ComNets-Bremen/WUSN/PCB-Layouts/MoleNet_v5.2.2/MoleNet_V5.2.2.kicad_pcb

## KiCad design PCB-Layouts/MoleNet_v5.2.2/MoleNet_V5.2.2.kicad_pcb (2024-08-29, an earlier design)

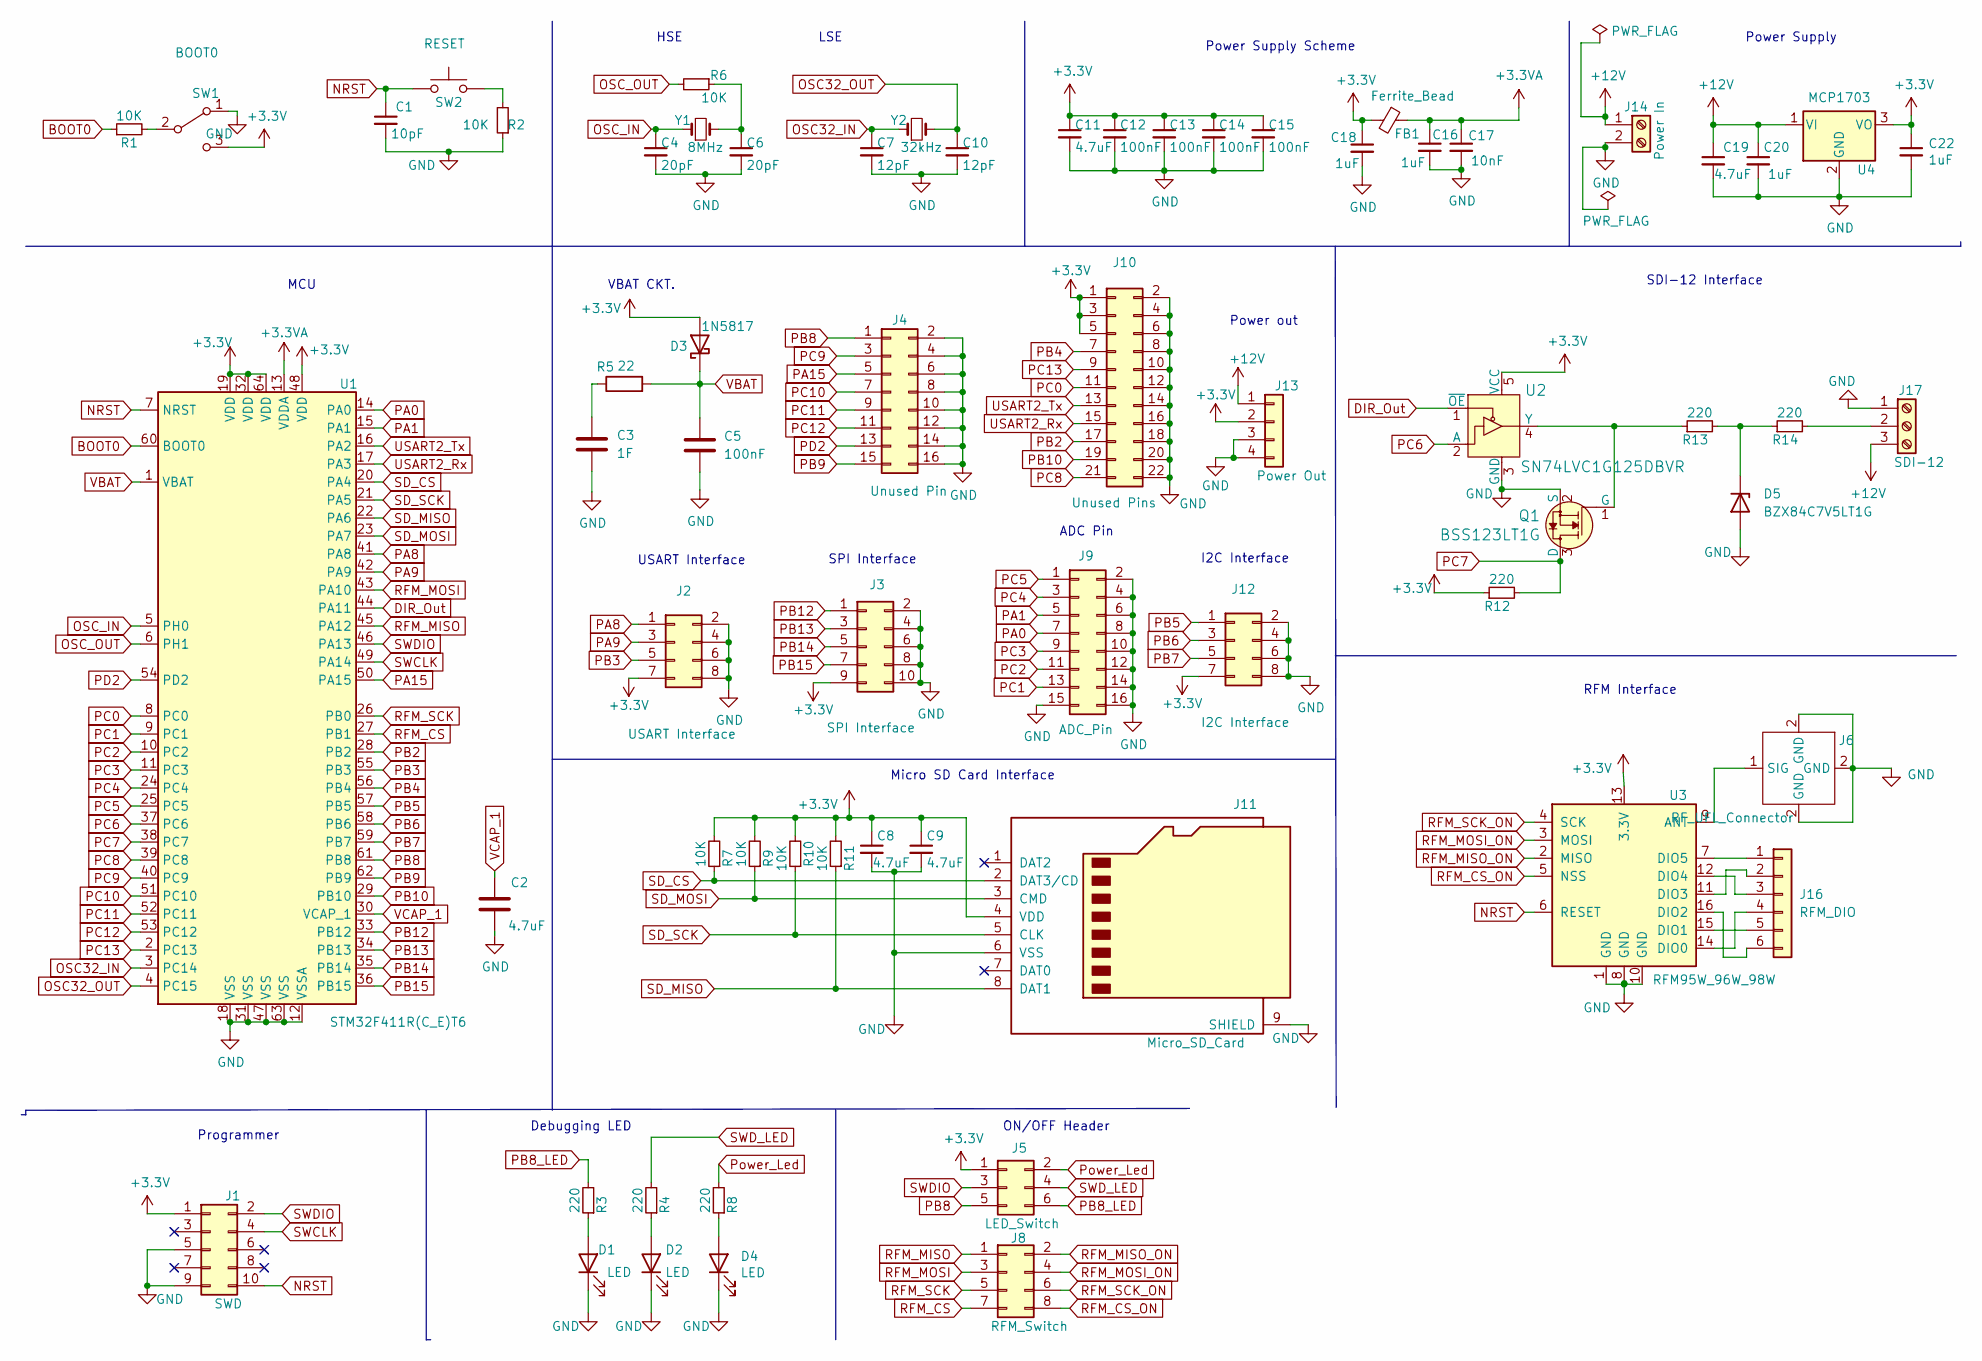
[picture p4: schematic MoleNet_V5.2.2.kicad_sch, MoleNet V5.2]

Parts:
C1: 10pF; C_0805_2012Metric
C2, C8, C9: 4.7uF; C_0402_1005Metric_Pad0.74x0.62mm_HandSolder
C3: 1F; C_Axial_L5.1mm_D3.1mm_P12.50mm_Horizontal
C4, C6: 20pF; C_0402_1005Metric_Pad0.74x0.62mm_HandSolder
C5, C12, C13, C14, C15: 100nF; C_0805_2012Metric_Pad1.18x1.45mm_HandSolder
C7, C10: 12pF; C_0402_1005Metric_Pad0.74x0.62mm_HandSolder
C11, C19: 4.7uF; C_0805_2012Metric_Pad1.18x1.45mm_HandSolder
C16, C18, C20, C22: 1uF; C_0805_2012Metric_Pad1.18x1.45mm_HandSolder
C17: 10nF; C_0805_2012Metric_Pad1.18x1.45mm_HandSolder
D1, D2, D4: LED; LED_0805_2012Metric_Pad1.15x1.40mm_HandSolder
D3: 1N5817; D_DO-41_SOD81_P10.16mm_Horizontal
D5: BZX84C7V5LT1G; SOT-23
FB1: Ferrite_Bead; L_0805_2012Metric_Pad1.05x1.20mm_HandSolder
J1: SWD; IDC-Header_2x05_P2.54mm_Vertical
J2: USART Interface; PinHeader_2x04_P2.54mm_Vertical
J3: SPI Interface; PinHeader_2x05_P2.54mm_Vertical
J4: Unused Pin; PinHeader_2x08_P2.54mm_Vertical
J5: LED_Switch; PinHeader_2x03_P2.54mm_Vertical
J6: RF_UFL_Connector; U.FL_Molex_MCRF_73412-0110_Vertical
J8: RFM_Switch; PinHeader_2x04_P2.54mm_Vertical
J9: ADC_Pin; PinHeader_2x08_P2.54mm_Vertical
J10: Unused Pins; PinHeader_2x11_P2.54mm_Vertical
J11: Micro_SD_Card; microSD_HC_Molex_104031-0811
J12: I2C Interface; PinHeader_2x04_P2.54mm_Vertical
J13: Power Out; PinHeader_1x04_P2.54mm_Vertical
J14: Power In; TerminalBlock_Phoenix_PT-1,5-2-3.5-H_1x02_P3.50mm_Horizontal
J16: RFM_DIO; PinHeader_1x06_P2.54mm_Vertical
J17: SDI-12; TerminalBlock_Phoenix_PT-1,5-3-3.5-H_1x03_P3.50mm_Horizontal
Q1: BSS123LT1G; SOT-23_Handsoldering; MPN BSS123; Digi-Key_PN BSS123NCT-ND
R1, R2: 10K; R_0805_2012Metric_Pad1.20x1.40mm_HandSolder
R3, R4, R8, R12, R13, R14: 220; R_0805_2012Metric_Pad1.20x1.40mm_HandSolder
R5: 22; R_0805_2012Metric_Pad1.20x1.40mm_HandSolder
R6, R7, R9, R10, R11: 10K; R_0402_1005Metric_Pad0.72x0.64mm_HandSolder
SW1: BOOT0; Switch_SPDT_THT
SW2: RESET; SW_PUSH_6mm_H4.3mm
U1: STM32F411R(C_E)T6; LQFP-64_10x10mm_P0.5mm
U2: SN74LVC1G125DBVR; SOT-23-5; MPN SN74LVC1G125DBVR; Digi-Key_PN 296-11603-1-ND
U3: RFM95W_96W_98W; HOPERF_RFM9XW_SMD
U4: MCP1703; SOT-223-3_TabPin2
Y1: 8MHz; Crystal_SMD_5032-2Pin_5.0x3.2mm
Y2: 32kHz; Crystal_SMD_3215-2Pin_3.2x1.5mm

Connections:
+3.3VA: C16.1, C17.1, FB1.1, U1.13 (VDDA)
+3V3: C8.1, C9.1, C11.1, C12.1, C13.1, C14.1, C15.1, C18.1, C22.1, D3.2 (A), FB1.2, J1.1, J2.7 (Pin_4), J3.9 (Pin_5), J5.1, J10.1, J10.3, J10.5, J11.4 (VDD), J12.7 (Pin_4), J13.2, R7.2, R9.2, R10.2, R11.2, R12.1, SW1.3 (C), U1.19 (VDD), U1.32 (VDD), U1.48 (VDD), U1.64 (VDD), U2.5 (VCC), U3.13 (3.3V), U4.3 (VO)
+12V: C19.1, C20.1, J13.1, J14.1, J17.3, U4.1 (VI)
BOOT0: R1.1, U1.60 (BOOT0)
DIR_Out: U1.44 (PA11), U2.1 (~OE)
GND: C1.2, C2.2, C3.2, C4.2, C5.2, C6.2, C7.2, C8.2, C9.2, C10.2, C11.2, C12.2, C13.2, C14.2, C15.2, C16.2, C17.2, C18.2, C19.2, C20.2, C22.2, D1.1 (K), D2.1 (K), D4.1 (K), D5.1 (A), J1.5, J1.9, J2.2 (Pin_5), J2.4 (Pin_6), J2.6 (Pin_7), J2.8, J3.2 (Pin_10), J3.4 (Pin_9), J3.6 (Pin_8), J3.8 (Pin_7), J3.10 (Pin_6), J4.2, J4.4, J4.6, J4.8, J4.10, J4.12, J4.14, J4.16, J6.2 (GND), J9.2, J9.4, J9.6, J9.8, J9.10, J9.12, J9.14, J9.15, J9.16, J10.2, J10.4, J10.6, J10.8, J10.10, J10.12, J10.14, J10.16, J10.18, J10.20, J10.22, J11.6 (VSS), J11.9 (SHIELD), J12.2 (Pin_5), J12.4 (Pin_6), J12.6 (Pin_7), J12.8, J13.3, J13.4, J14.2, J17.1, Q1.2 (S), R2.1, SW1.1 (A), U1.12 (VSSA), U1.18 (VSS), U1.31 (VSS), U1.47 (VSS), U1.63 (VSS), U2.3 (GND), U3.1 (GND), U3.8 (GND), U3.10 (GND), U4.2 (GND)
NRST: C1.1, J1.10, SW2.1, U1.7 (NRST), U3.6 (RESET)
unnamed: C3.1, R5.1
unnamed: C6.1, R6.1, Y1.2
unnamed: D1.2 (A), R3.1
unnamed: D2.2 (A), R4.1
unnamed: D4.2 (A), R8.1
unnamed: D5.3 (K), R13.2, R14.1
unnamed: J6.1 (SIG), U3.9 (ANT)
unnamed: J16.1, U3.7 (DIO5)
unnamed: J16.2, U3.11 (DIO3)
unnamed: J16.3, U3.12 (DIO4)
unnamed: J16.4, U3.14 (DIO0)
unnamed: J16.5, U3.15 (DIO1)
unnamed: J16.6, U3.16 (DIO2)
unnamed: J17.2, R14.2
unnamed: Q1.1 (G), R13.1, U2.4 (Y)
unnamed: R1.2, SW1.2 (B)
unnamed: R2.2, SW2.2
OSC32_IN: C7.1, U1.3 (PC14), Y2.1
OSC32_OUT: C10.1, U1.4 (PC15), Y2.2
OSC_IN: C4.1, U1.5 (PH0), Y1.1
OSC_OUT: R6.2, U1.6 (PH1)
PA0: J9.7, U1.14 (PA0)
PA1: J9.5, U1.15 (PA1)
PA8: J2.1, U1.41 (PA8)
PA9: J2.3 (Pin_2), U1.42 (PA9)
PA15: J4.5, U1.50 (PA15)
PB2: J10.17, U1.28 (PB2)
PB3: J2.5 (Pin_3), U1.55 (PB3)
PB4: J10.7, U1.56 (PB4)
PB5: J12.1, U1.57 (PB5)
PB6: J12.3 (Pin_2), U1.58 (PB6)
PB7: J12.5 (Pin_3), U1.59 (PB7)
PB8: J4.1, J5.5 (Pin_3), U1.61 (PB8)
PB8_LED: J5.6, R3.2
PB9: J4.15, U1.62 (PB9)
PB10: J10.19, U1.29 (PB10)
PB12: J3.1, U1.33 (PB12)
PB13: J3.3 (Pin_2), U1.34 (PB13)
PB14: J3.5 (Pin_3), U1.35 (PB14)
PB15: J3.7 (Pin_4), U1.36 (PB15)
PC0: J10.11, U1.8 (PC0)
PC1: J9.13, U1.9 (PC1)
PC2: J9.11, U1.10 (PC2)
PC3: J9.9, U1.11 (PC3)
PC4: J9.3, U1.24 (PC4)
PC5: J9.1, U1.25 (PC5)
PC6: U1.37 (PC6), U2.2 (A)
PC7: Q1.3 (D), R12.2, U1.38 (PC7)
PC8: J10.21, U1.39 (PC8)
PC9: J4.3, U1.40 (PC9)
PC10: J4.7, U1.51 (PC10)
PC11: J4.9, U1.52 (PC11)
PC12: J4.11, U1.53 (PC12)
PC13: J10.9, U1.2 (PC13)
PD2: J4.13, U1.54 (PD2)
Power_Led: J5.2 (Pin_4), R8.2
RFM_CS: J8.7, U1.27 (PB1)
RFM_CS_ON: J8.8, U3.5 (NSS)
RFM_MISO: J8.1, U1.45 (PA12)
RFM_MISO_ON: J8.2, U3.2 (MISO)
RFM_MOSI: J8.3, U1.43 (PA10)
RFM_MOSI_ON: J8.4, U3.3 (MOSI)
RFM_SCK: J8.5, U1.26 (PB0)
RFM_SCK_ON: J8.6, U3.4 (SCK)
SD_CS: J11.2 (DAT3/CD), R7.1, U1.20 (PA4)
SD_MISO: J11.8 (DAT1), R11.1, U1.22 (PA6)
SD_MOSI: J11.3 (CMD), R9.1, U1.23 (PA7)
SD_SCK: J11.5 (CLK), R10.1, U1.21 (PA5)
SWCLK: J1.4, U1.49 (PA14)
SWDIO: J1.2, J5.3 (Pin_2), U1.46 (PA13)
SWD_LED: J5.4 (Pin_5), R4.2
USART2_Rx: J10.15, U1.17 (PA3)
USART2_Tx: J10.13, U1.16 (PA2)
VBAT: C5.1, D3.1 (K), R5.2, U1.1 (VBAT)
VCAP_1: C2.1, U1.30 (VCAP_1)

Notes on the sheet:
VBAT CKT.
SPI Interface
RFM Interface
Power out
Micro SD Card Interface
SDI-12 Interface
I2C Interface
HSE
Programmer
ADC Pin
Power Supply
MCU
Power Supply Scheme
ON/OFF Header
LSE
Debugging LED
USART Interface

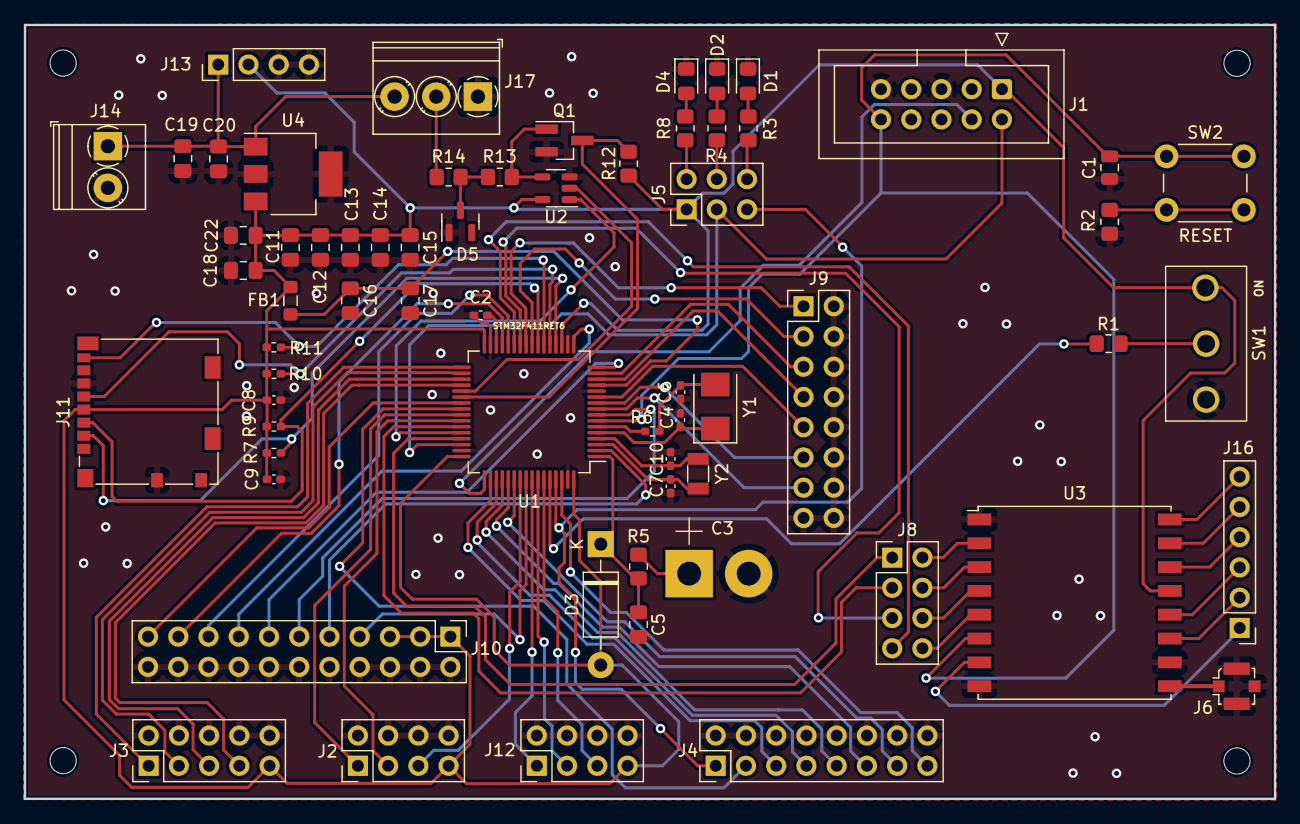
[picture p5: board MoleNet_V5.2.2.kicad_pcb from above]

Board: 2 copper layers, 105.0 x 65.0 mm, 65 parts (0 on the bottom side), 82 nets.
