ComNets-Bremen/WUSN/PCB-Layouts/MoleNet_v5.1/MoleNet_v5.01.kicad_pcb

## KiCad design PCB-Layouts/MoleNet_v5.1/MoleNet_v5.01.kicad_pcb (2024-08-29, an earlier design)

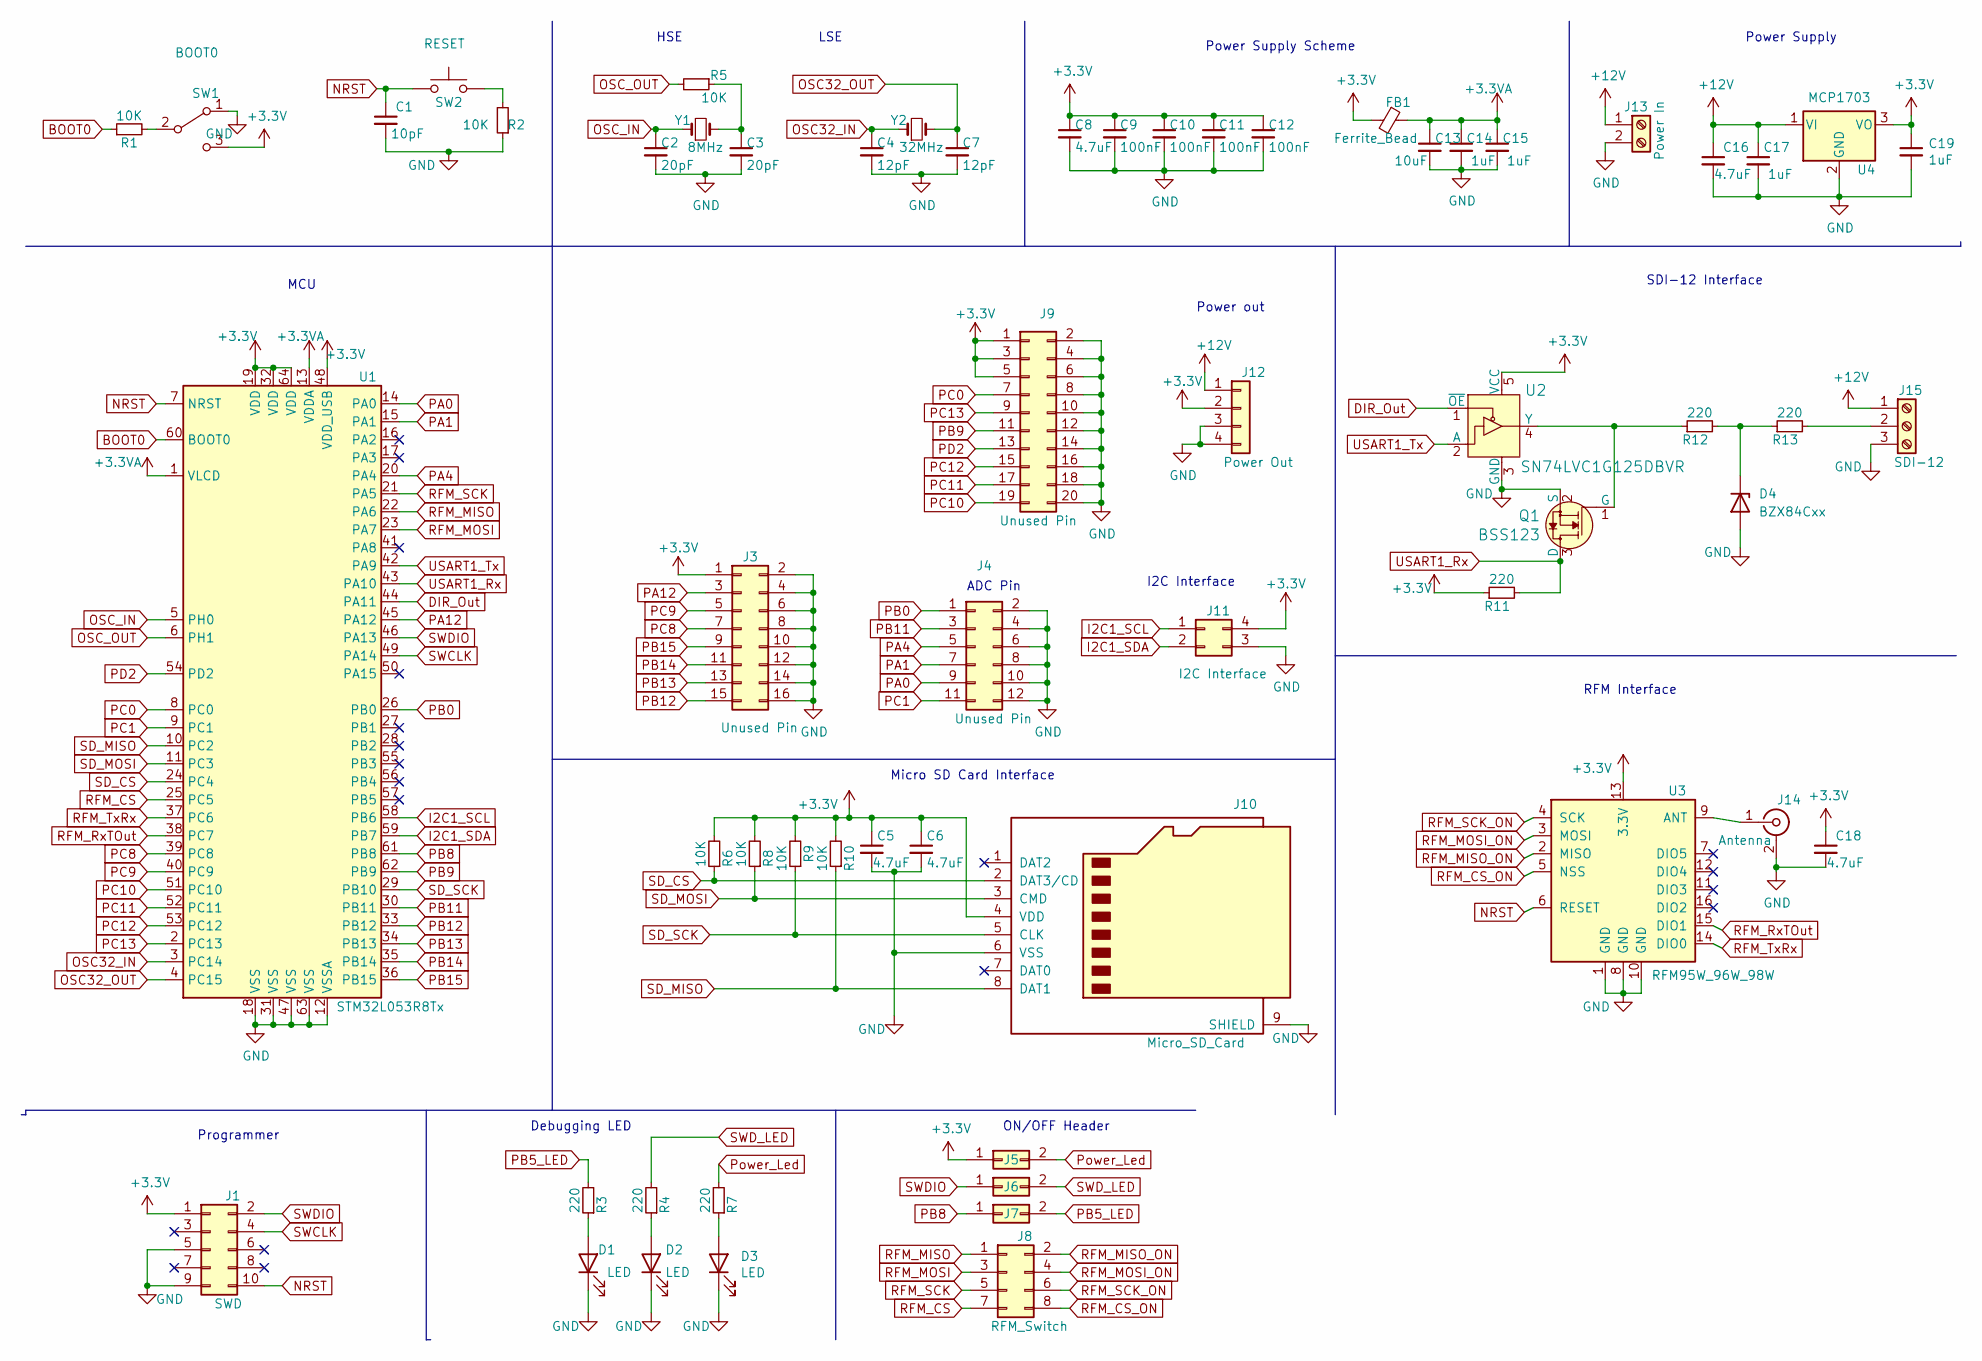
[picture p6: schematic MoleNet_v5.01.kicad_sch, MoleNet]

Parts:
C1: 10pF; C_0805_2012Metric
C2, C3: 20pF; C_0402_1005Metric
C4, C7: 12pF; C_0402_1005Metric
C5, C6, C16, C18: 4.7uF; C_0805_2012Metric
C8: 4.7uF; C_0402_1005Metric
C9, C10, C11, C12: 100nF; C_0402_1005Metric
C13: 10uF; C_0402_1005Metric
C14, C15: 1uF; C_0402_1005Metric
C17, C19: 1uF; C_0805_2012Metric
D1, D2, D3: LED; LED_0805_2012Metric
D4: BZX84Cxx; SOT-23
FB1: Ferrite_Bead; L_0805_2012Metric
J1: SWD; IDC-Header_2x05_P2.54mm_Vertical
J3: Unused Pin; PinHeader_2x08_P2.54mm_Vertical
J4: Unused Pin; PinHeader_2x06_P2.54mm_Vertical
J5, J6, J7: Conn_02x01; PinHeader_2x01_P2.54mm_Vertical
J8: RFM_Switch; PinHeader_2x04_P2.54mm_Vertical
J9: Unused Pin; PinHeader_2x10_P2.54mm_Vertical
J10: Micro_SD_Card; microSD_HC_Wuerth_693072010801
J11: I2C Interface; PinHeader_2x02_P2.54mm_Vertical
J12: Power Out; PinHeader_1x04_P2.54mm_Vertical
J13: Power In; TerminalBlock_Phoenix_PT-1,5-2-3.5-H_1x02_P3.50mm_Horizontal
J14: Antenna; SMA_Amphenol_132134_Vertical
J15: SDI-12; TerminalBlock_Phoenix_PT-1,5-3-3.5-H_1x03_P3.50mm_Horizontal
Q1: BSS123; SOT-23_Handsoldering; MPN BSS123; Digi-Key_PN BSS123NCT-ND
R1, R2, R6, R8, R9, R10: 10K; R_0805_2012Metric
R3, R4, R7, R11, R12, R13: 220; R_0805_2012Metric
R5: 10K; R_0402_1005Metric
SW1: BOOT0; SW_SPDT_CK-JS102011SAQN
SW2: RESET; SW_SPST_B3SL-1022P
U1: STM32L053R8Tx; LQFP-64_10x10mm_P0.5mm
U2: SN74LVC1G125DBVR; SOT-23-5; MPN SN74LVC1G125DBVR; Digi-Key_PN 296-11603-1-ND
U3: RFM95W_96W_98W; HOPERF_RFM9XW_SMD
U4: MCP1703; SOT-223-3_TabPin2
Y1: 8MHz; Crystal_SMD_5032-2Pin_5.0x3.2mm
Y2: 32MHz; Crystal_SMD_3215-2Pin_3.2x1.5mm

Connections:
+3.3VA: C13.1, C14.1, C15.1, FB1.1, U1.1 (VLCD), U1.13 (VDDA)
+3V3: C5.1, C6.1, C8.1, C9.1, C10.1, C11.1, C12.1, C18.1, C19.1, FB1.2, J1.1, J3.1, J5.1, J9.1, J9.3, J9.5, J10.4 (VDD), J11.4, J12.2, R6.2, R8.2, R9.2, R10.2, R11.1, SW1.3 (C), U1.19 (VDD), U1.32 (VDD), U1.48 (VDD_USB), U1.64 (VDD), U2.5 (VCC), U3.13 (3.3V), U4.3 (VO)
+12V: C16.1, C17.1, J12.1, J13.1, J15.1, U4.1 (VI)
BOOT0: R1.1, U1.60 (BOOT0)
DIR_Out: U1.44 (PA11), U2.1 (~OE)
GND: C1.2, C2.2, C3.2, C4.2, C5.2, C6.2, C7.2, C8.2, C9.2, C10.2, C11.2, C12.2, C13.2, C14.2, C15.2, C16.2, C17.2, C18.2, C19.2, D1.1 (K), D2.1 (K), D3.1 (K), D4.1 (A), J1.5, J1.9, J3.2, J3.4, J3.6, J3.8, J3.10, J3.12, J3.14, J3.16, J4.2, J4.4, J4.6, J4.8, J4.10, J4.12, J9.2, J9.4, J9.6, J9.8, J9.10, J9.12, J9.14, J9.16, J9.18, J9.20, J10.6 (VSS), J10.9 (SHIELD), J11.3, J12.3, J12.4, J13.2, J14.2 (Ext), J15.3, Q1.2 (S), R2.1, SW1.1 (A), U1.12 (VSSA), U1.18 (VSS), U1.31 (VSS), U1.47 (VSS), U1.63 (VSS), U2.3 (GND), U3.1 (GND), U3.8 (GND), U3.10 (GND), U4.2 (GND)
I2C1_SCL: J11.1, U1.58 (PB6)
I2C1_SDA: J11.2, U1.59 (PB7)
NRST: C1.1, J1.10, SW2.1, U1.7 (NRST), U3.6 (RESET)
unnamed: C3.1, R5.1, Y1.2
unnamed: D1.2 (A), R3.1
unnamed: D2.2 (A), R4.1
unnamed: D3.2 (A), R7.1
unnamed: D4.3 (K), R12.2, R13.1
unnamed: J14.1 (In), U3.9 (ANT)
unnamed: J15.2, R13.2
unnamed: Q1.1 (G), R12.1, U2.4 (Y)
unnamed: R1.2, SW1.2 (B)
unnamed: R2.2, SW2.2
OSC32_IN: C4.1, U1.3 (PC14), Y2.1
OSC32_OUT: C7.1, U1.4 (PC15), Y2.2
OSC_IN: C2.1, U1.5 (PH0), Y1.1
OSC_OUT: R5.2, U1.6 (PH1)
PA0: J4.9, U1.14 (PA0)
PA1: J4.7, U1.15 (PA1)
PA4: J4.5, U1.20 (PA4)
PA12: J3.3, U1.45 (PA12)
PB0: J4.1, U1.26 (PB0)
PB5_LED: J7.2, R3.2
PB8: J7.1, U1.61 (PB8)
PB9: J9.11, U1.62 (PB9)
PB11: J4.3, U1.30 (PB11)
PB12: J3.15, U1.33 (PB12)
PB13: J3.13, U1.34 (PB13)
PB14: J3.11, U1.35 (PB14)
PB15: J3.9, U1.36 (PB15)
PC0: J9.7, U1.8 (PC0)
PC1: J4.11, U1.9 (PC1)
PC8: J3.7, U1.39 (PC8)
PC9: J3.5, U1.40 (PC9)
PC10: J9.19, U1.51 (PC10)
PC11: J9.17, U1.52 (PC11)
PC12: J9.15, U1.53 (PC12)
PC13: J9.9, U1.2 (PC13)
PD2: J9.13, U1.54 (PD2)
Power_Led: J5.2, R7.2
RFM_CS: J8.7, U1.25 (PC5)
RFM_CS_ON: J8.8, U3.5 (NSS)
RFM_MISO: J8.1, U1.22 (PA6)
RFM_MISO_ON: J8.2, U3.2 (MISO)
RFM_MOSI: J8.3, U1.23 (PA7)
RFM_MOSI_ON: J8.4, U3.3 (MOSI)
RFM_RxTOut: U1.38 (PC7), U3.15 (DIO1)
RFM_SCK: J8.5, U1.21 (PA5)
RFM_SCK_ON: J8.6, U3.4 (SCK)
RFM_TxRx: U1.37 (PC6), U3.14 (DIO0)
SD_CS: J10.2 (DAT3/CD), R6.1, U1.24 (PC4)
SD_MISO: J10.8 (DAT1), R10.1, U1.10 (PC2)
SD_MOSI: J10.3 (CMD), R8.1, U1.11 (PC3)
SD_SCK: J10.5 (CLK), R9.1, U1.29 (PB10)
SWCLK: J1.4, U1.49 (PA14)
SWDIO: J1.2, J6.1, U1.46 (PA13)
SWD_LED: J6.2, R4.2
USART1_Rx: Q1.3 (D), R11.2, U1.43 (PA10)
USART1_Tx: U1.42 (PA9), U2.2 (A)

Notes on the sheet:
Power Supply Scheme
Power out
Debugging LED
I2C Interface
LSE
SDI-12 Interface
Micro SD Card Interface
ON/OFF Header
ADC Pin
Programmer
Power Supply
MCU
HSE
RFM Interface
