ComNets-Bremen/WUSN/PCB-Layouts/MoleNet_v5.1/MoleNet_v5.01.kicad_pcb

## KiCad design PCB-Layouts/MoleNet_v5.1/MoleNet_v5.01.kicad_pcb (continued)

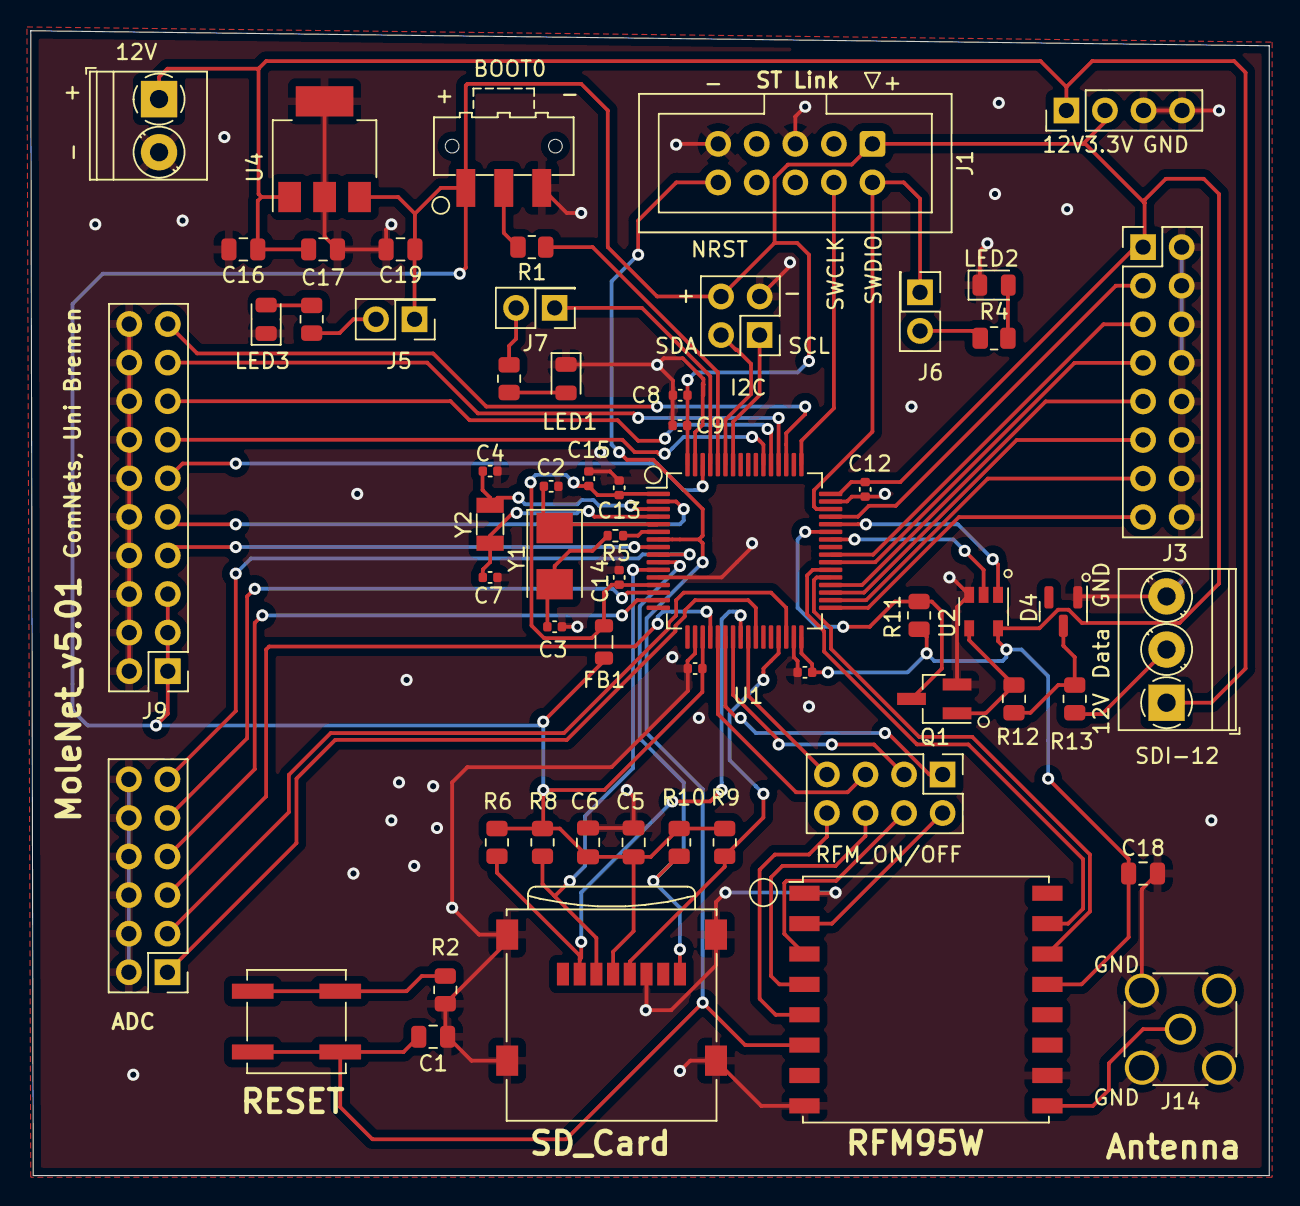
[picture p7: board MoleNet_v5.01.kicad_pcb from above]

Board: 2 copper layers, 81.6 x 75.4 mm, 60 parts (0 on the bottom side), 65 nets.
