ComNets-Bremen/WUSN/Auxiliary Boards/Uart-Sdi12 Conversion Board/Uart-Sdi.kicad_pcb

## KiCad design Auxiliary Boards/Uart-Sdi12 Conversion Board/Uart-Sdi.kicad_pcb (2024-09-02)

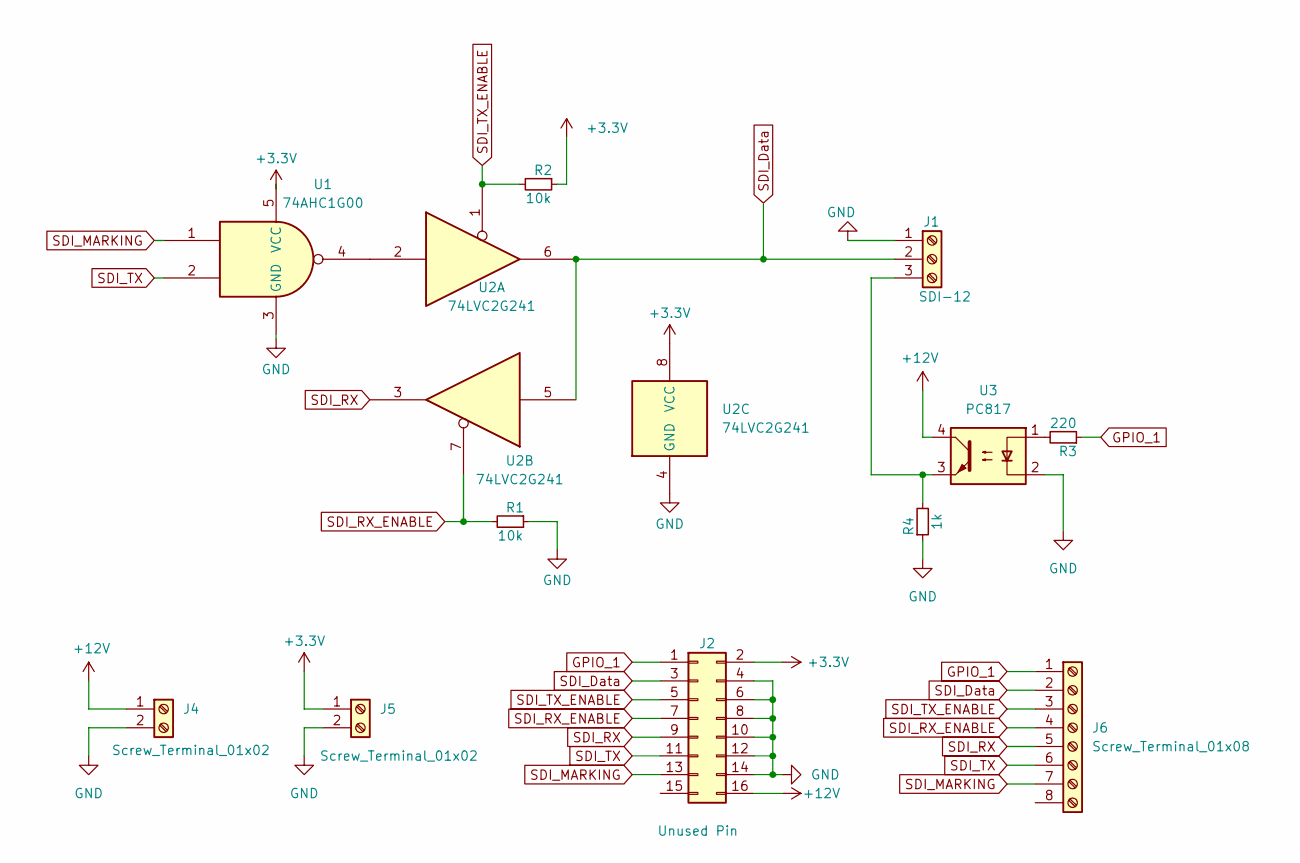
[picture p8: schematic Uart-Sdi.kicad_sch, UART/SDI-12 Interface]

Parts:
J1: SDI-12; TerminalBlock_Phoenix_PT-1,5-3-3.5-H_1x03_P3.50mm_Horizontal; JLC PART C91152
J2: Unused Pin; PinHeader_2x08_P2.54mm_Vertical
J4, J5: Screw_Terminal_01x02; TerminalBlock_Phoenix_PT-1,5-2-3.5-H_1x02_P3.50mm_Horizontal
J6: Screw_Terminal_01x08; TerminalBlock_Phoenix_PT-1,5-8-3.5-H_1x08_P3.50mm_Horizontal
R1, R2: 10k; R_0805_2012Metric_Pad1.20x1.40mm_HandSolder
R3: 220; R_0805_2012Metric_Pad1.20x1.40mm_HandSolder
R4: 1k; R_0805_2012Metric_Pad1.20x1.40mm_HandSolder
U1: 74AHC1G00; SOT-353_SC-70-5
U2: 74LVC2G241; SSOP-8_2.95x2.8mm_P0.65mm
U3: PC817; DIP-4_W7.62mm

Connections:
+3.3V: J2.2, J5.1, R2.1, U1.5 (VCC), U2.8 (VCC)
+12V: J2.16, J4.1, U3.4
GND: J1.1, J2.4, J2.6, J2.8, J2.10, J2.12, J2.14, J4.2, J5.2, R1.1, R4.1, U1.3 (GND), U2.4 (GND), U3.2
GPIO_1: J2.1, J6.1, R3.1
unnamed: J1.3, R4.2, U3.3
unnamed: R3.2, U3.1
unnamed: U1.4, U2.2
SDI_Data: J1.2, J2.3, J6.2, U2.5, U2.6
SDI_MARKING: J2.13, J6.7, U1.1
SDI_RX: J2.9, J6.5, U2.3
SDI_RX_ENABLE: J2.7, J6.4, R1.2, U2.7
SDI_TX: J2.11, J6.6, U1.2
SDI_TX_ENABLE: J2.5, J6.3, R2.2, U2.1

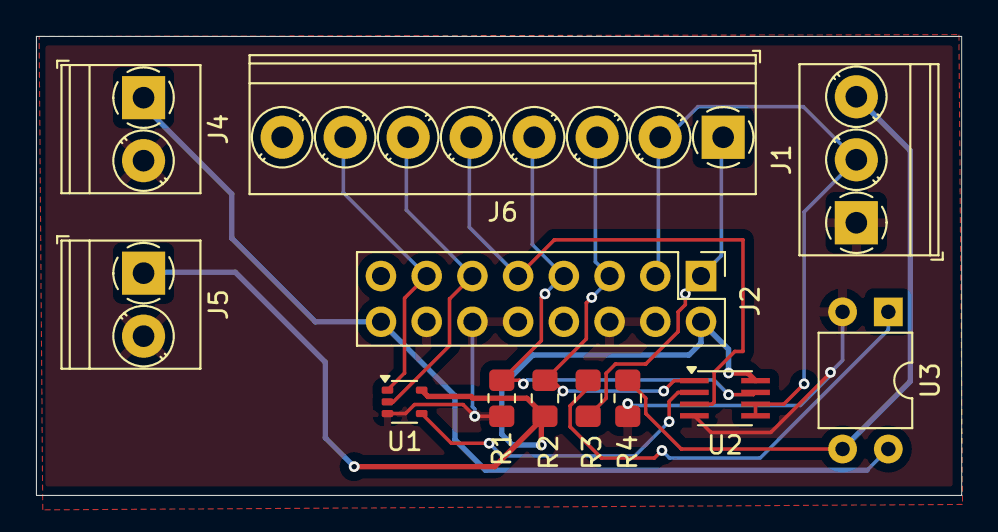
[picture p9: board Uart-Sdi.kicad_pcb from above]

Board: 2 copper layers, 51.4 x 25.5 mm, 12 parts (0 on the bottom side), 13 nets.
