ComNets-Bremen/WUSN/(notices)

Notices in the files:
parts and their libraries:
SparkFun-RF: Licensing: Creative Commons ShareAlike 4.0 International - https://creativecommons.org/licenses/by-sa/4.0
Terminal_Blocks_Connectors_rev15e: Copyright: Würth Elektronik
